mkfarrow/Eurorack_Dual-VCS/README.md

# Eurorack_Dual-VCS

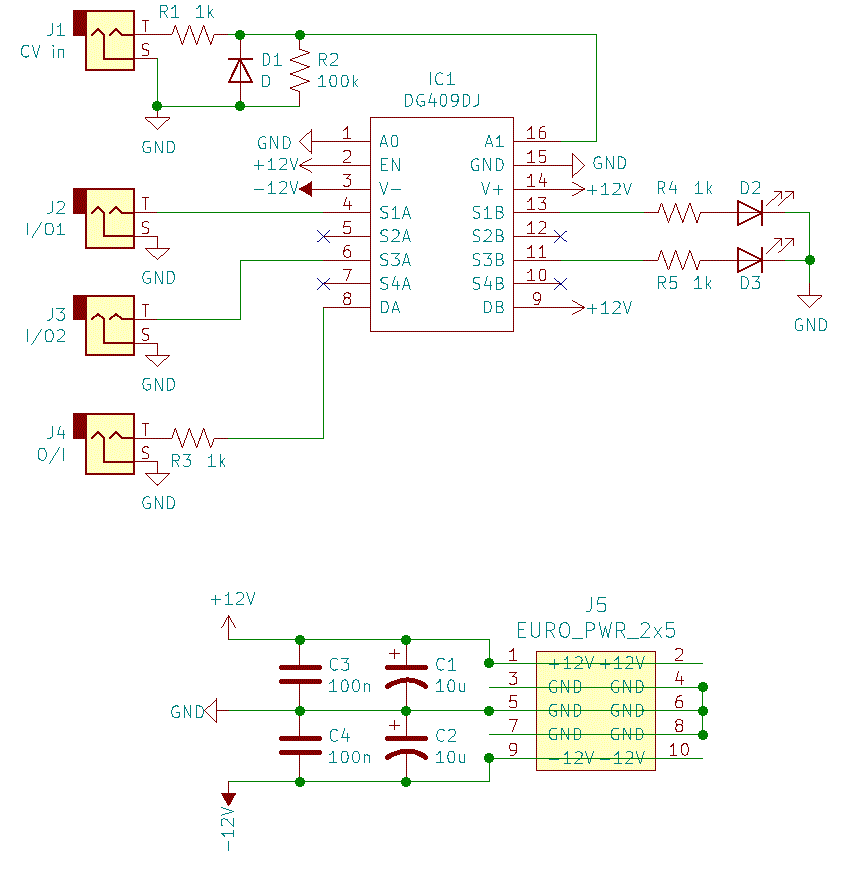
[picture p1: schematic.gif]
schematic
