mkfarrow/Eurorack_Dual-VCS/panel/dual-VCS_panel.png

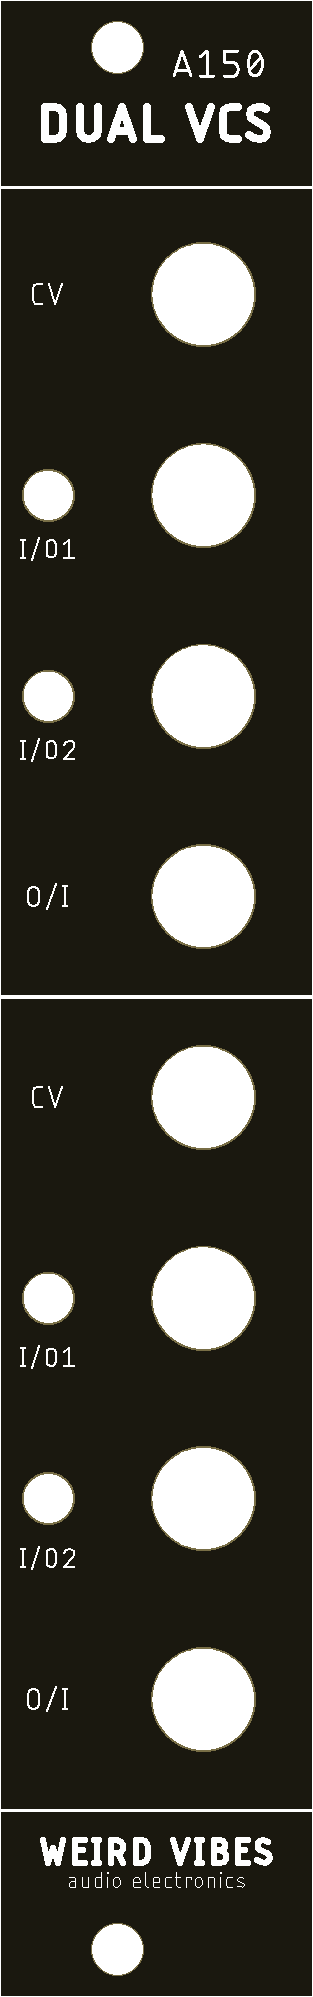
panel/dual-VCS_panel.png
