mkfarrow/Eurorack_Dual-VCS/Dual_VCS_schematic.pdf

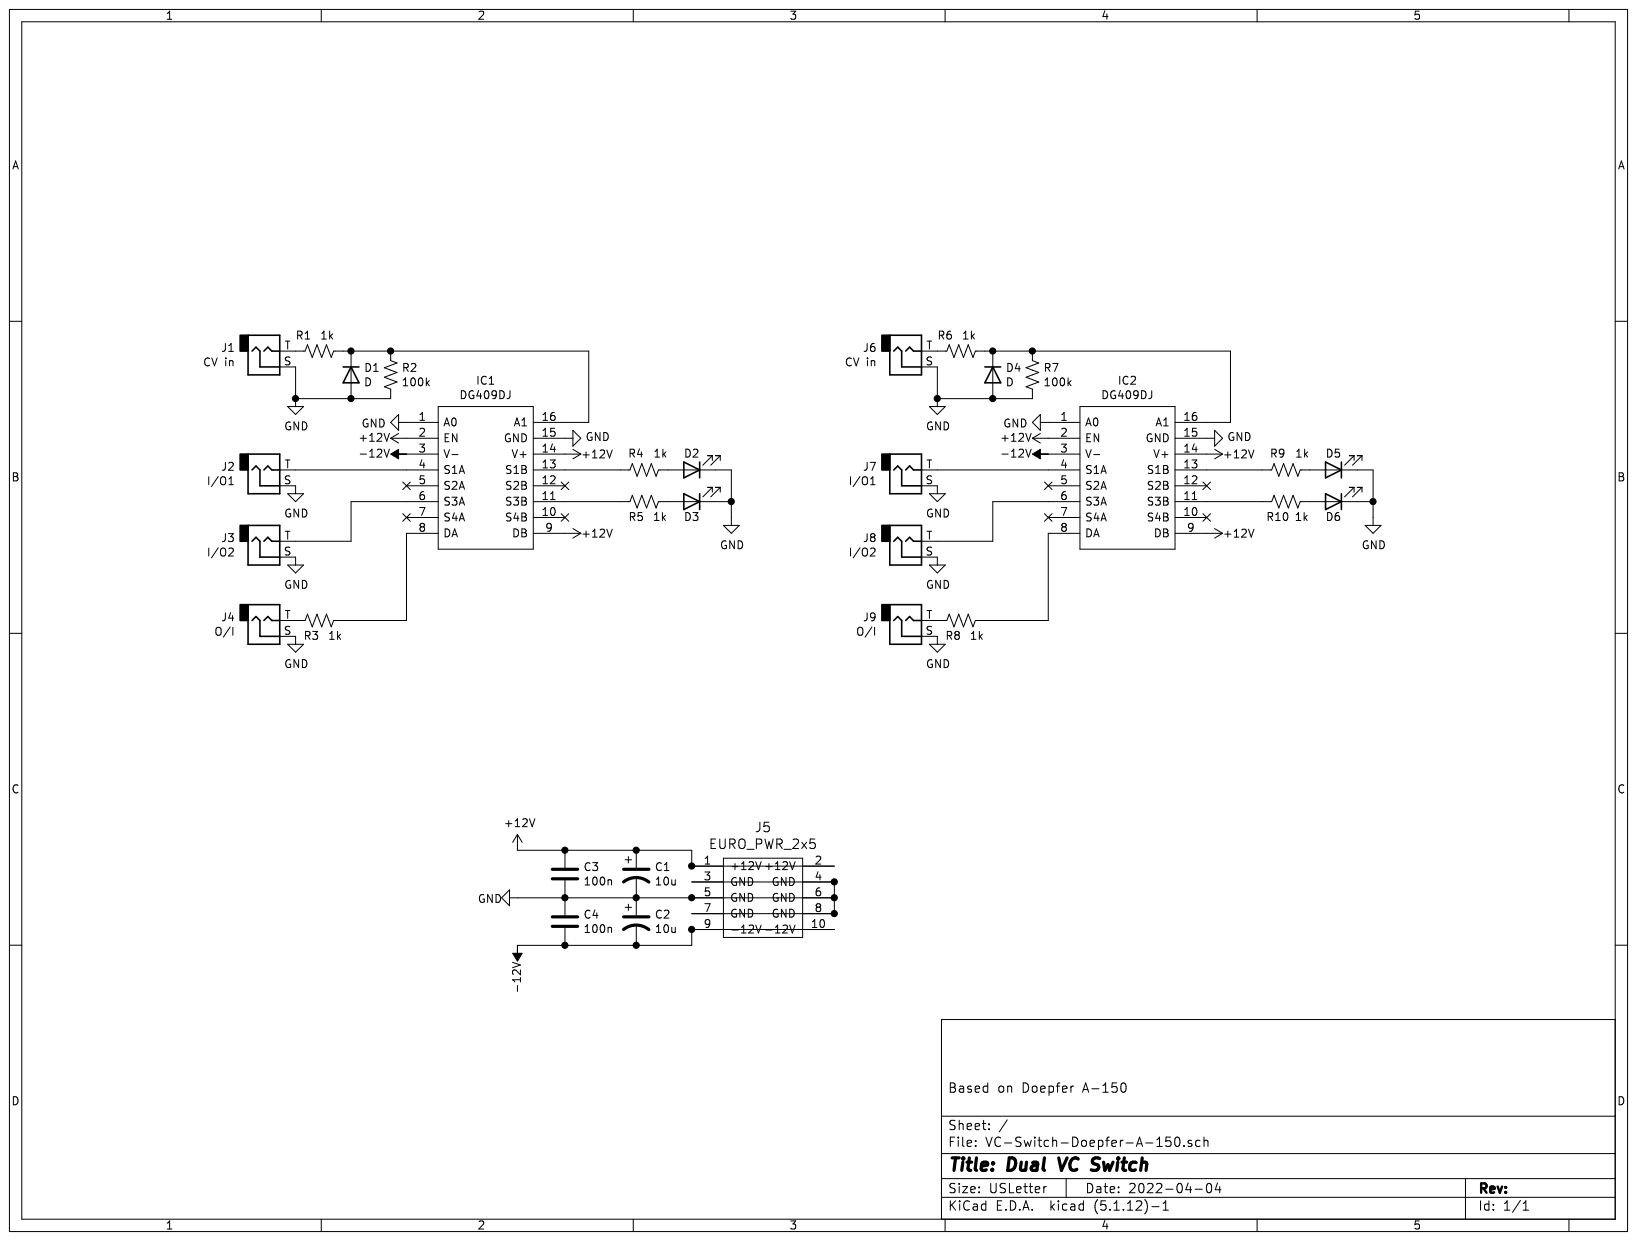
[picture p3: page 1]
