mkfarrow/Eurorack_Dual-VCS/pcb_kicad/VC-Switch-Doepfer-A-150.kicad_pcb

## KiCad design pcb_kicad/VC-Switch-Doepfer-A-150.kicad_pcb (2023-02-24)

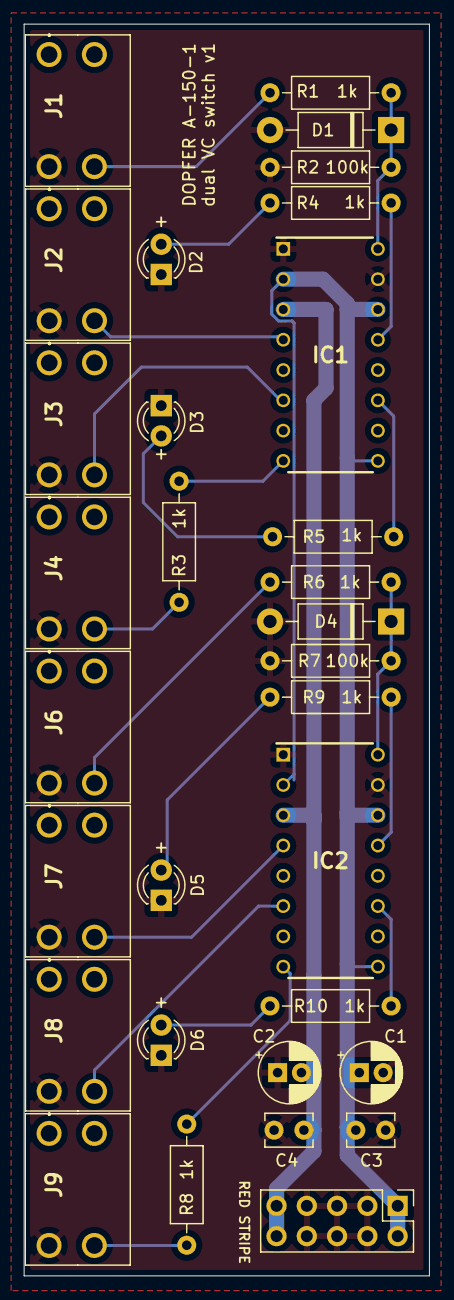
[picture p4: board VC-Switch-Doepfer-A-150.kicad_pcb from above]

Board: 2 copper layers, 34.0 x 105.0 mm, 31 parts (0 on the bottom side), 23 nets.

Parts:
C1, C2: 10u; CP_Radial_D5.0mm_P2.00mm
C3, C4: 100n; C_Disc_D3.8mm_W2.6mm_P2.50mm
D1, D4: D; D_DO-41_SOD81_P10.16mm_Horizontal
D2, D3, D5, D6: LED; LED_D3.0mm
IC1, IC2: DG409DJ; DIP794W56P254L1917H533Q16N
J1, J6: CV in; CL1384
J2, J7: I/O1; CL1384
J3, J8: I/O2; CL1384
J4, J9: O/I; CL1384
J5: EURO_PWR_2x5; PinHeader_2x05_P2.54mm_Vertical
R1, R3, R4, R5, R6, R8, R9, R10: 1k; R_Axial_DIN0207_L6.3mm_D2.5mm_P10.16mm_Horizontal
R2, R7: 100k; R_Axial_DIN0207_L6.3mm_D2.5mm_P10.16mm_Horizontal

Connections:
+12V: C1.1, C3.1, IC1.2, IC1.9, IC1.14, IC2.2, IC2.9, IC2.14, J5.1, J5.2
-12V: C2.2, C4.2, IC1.3, IC2.3, J5.9, J5.10
GND: C1.2, C2.1, C3.2, C4.1, D1.2, D2.1, D3.1, D4.2, D5.1, D6.1, IC1.1, IC1.15, IC2.1, IC2.15, J1.S, J2.S, J3.S, J4.S, J5.3, J5.4, J5.5, J5.6, J5.7, J5.8, J6.S, J7.S, J8.S, J9.S, R2.2, R7.2
unnamed: D1.1, IC1.16, R1.1, R2.1
unnamed: D2.2, R4.2
unnamed: D3.2, R5.2
unnamed: D4.1, IC2.16, R6.1, R7.1
unnamed: D5.2, R9.2
unnamed: D6.2, R10.2
unnamed: IC1.4, J2.T
unnamed: IC1.6, J3.T
unnamed: IC1.8, R3.2
unnamed: IC1.11, R5.1
unnamed: IC1.13, R4.1
unnamed: IC2.4, J7.T
unnamed: IC2.6, J8.T
unnamed: IC2.8, R8.2
unnamed: IC2.11, R10.1
unnamed: IC2.13, R9.1
unnamed: J1.T, R1.2
unnamed: J4.T, R3.1
unnamed: J6.T, R6.2
unnamed: J9.T, R8.1
