mkfarrow/Eurorack_Dual-VCS/pcb_kicad/VC-Switch-Doepfer-A-150.sch

## KiCad design pcb_kicad/VC-Switch-Doepfer-A-150.sch (2023-02-24)

Schematic: VC-Switch-Doepfer-A-150.sch

Parts:
C1, C2: 10u; CP_Radial_D5.0mm_P2.00mm
C3, C4: 100n; C_Disc_D3.8mm_W2.6mm_P2.50mm
D1, D4: D; D_DO-41_SOD81_P10.16mm_Horizontal
D2, D3, D5, D6: LED; LED_D3.0mm
IC1, IC2: DG409DJ; DIP794W56P254L1917H533Q16N; Manufacturer_Part_Number DG409DJZ; Mouser Part Number 968-DG409DJZ
J1, J6: CV in; Kobiconn-161-50132-Ex
J2, J7: I/O1; Kobiconn-161-50132-Ex
J3, J8: I/O2; Kobiconn-161-50132-Ex
J4, J9: O/I; Kobiconn-161-50132-Ex
J5: EURO_PWR_2x5; PinHeader_2x05_P2.54mm_Vertical
R1, R3, R4, R5, R6, R8, R9, R10: 1k; R_Axial_DIN0207_L6.3mm_D2.5mm_P10.16mm_Horizontal
R2, R7: 100k; R_Axial_DIN0207_L6.3mm_D2.5mm_P10.16mm_Horizontal
