mkfarrow/Eurorack_Dual-VCS/(commit log)

2022-06-10 adding files for panel
    [dual-VCS_panel.brd]
2022-12-22 adding images
    [dual-VCS_panel.brd]
2023-02-24 added kicad project for PCB
    [VC-Switch-Doepfer-A-150.kicad_pcb, VC-Switch-Doepfer-A-150.sch, dual-VCS_panel.brd]
